Nehsto/Magnetic-Actuation-Board/Board_V2.0/CAD_files/MagnetCore_h=1cm.SLDPRT

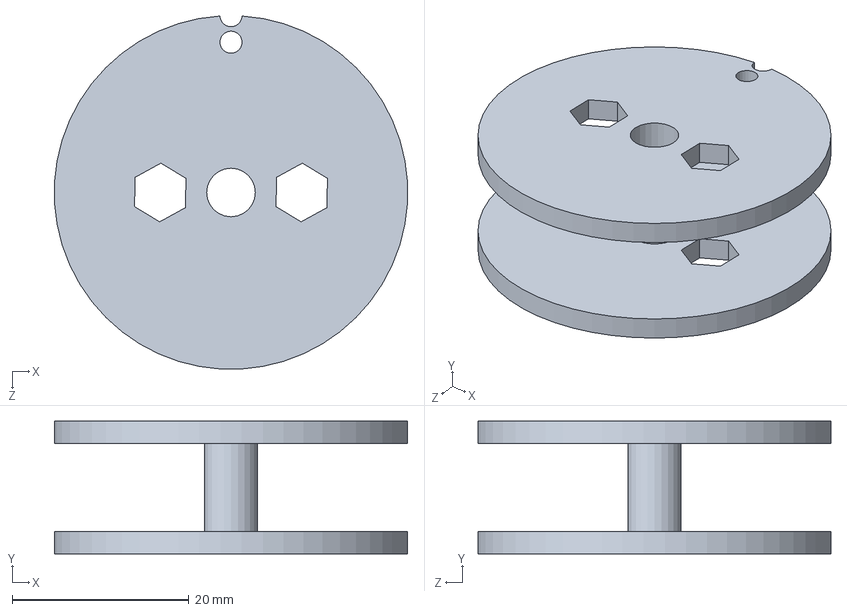
[picture p9: CAD file, 2025-11-26]
Board_V2.0/CAD_files/MagnetCore_h=1cm.SLDPRT
39.9 x 15.0 x 39.9 mm
