Nehsto/Magnetic-Actuation-Board/Board_V2.0/CAD_files/BoardHold.SLDPRT

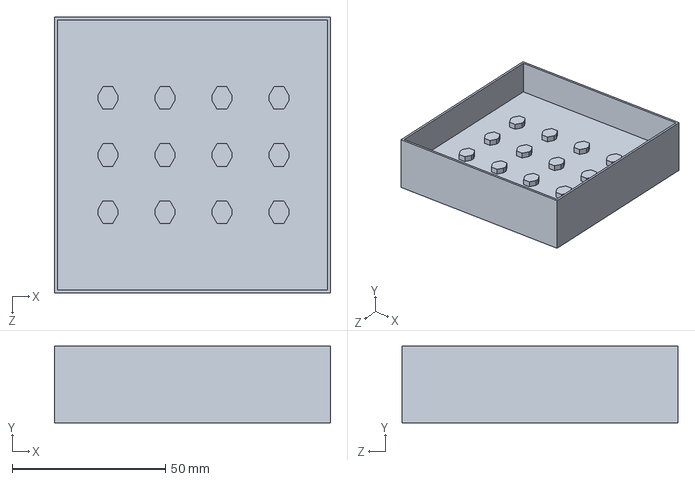
[picture p10: CAD file, 2025-11-26]
Board_V2.0/CAD_files/BoardHold.SLDPRT
90.0 x 25.0 x 90.0 mm
