Nehsto/Magnetic-Actuation-Board/Board_V2.0/CAD_files/Electromagnet v3.stl

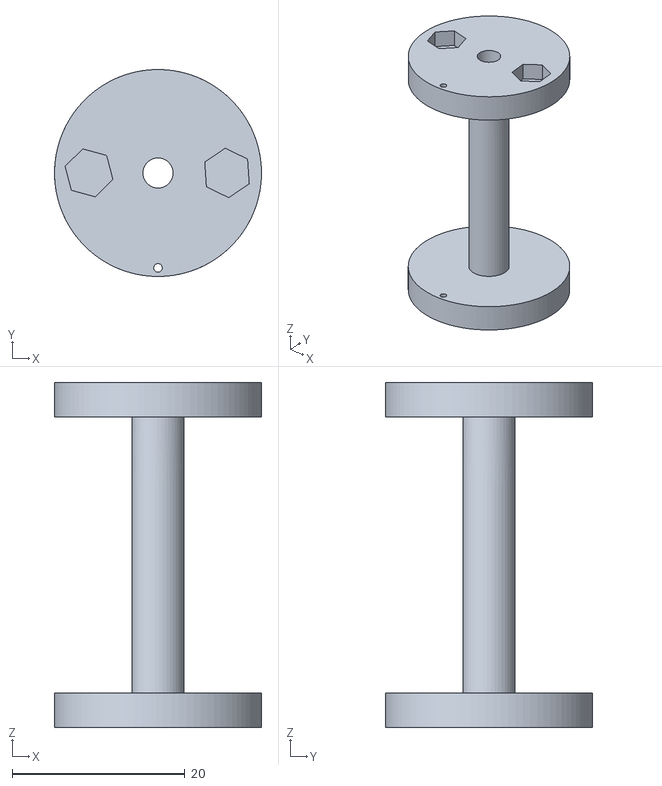
[picture p11: CAD file, 2025-11-26]
Board_V2.0/CAD_files/Electromagnet v3.stl
24.0 x 24.0 x 40.0
