Nehsto/Magnetic-Actuation-Board/Board_V2.0/CAD_files/MagnetCore_h=3cm.SLDPRT

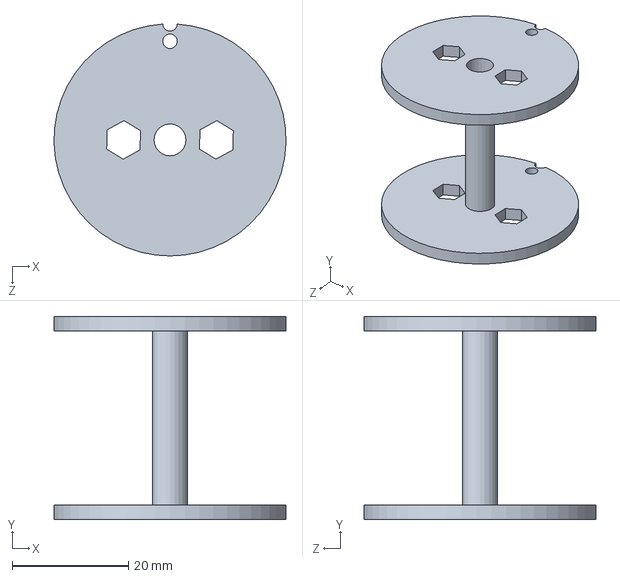
[picture p12: CAD file, 2025-11-26]
Board_V2.0/CAD_files/MagnetCore_h=3cm.SLDPRT
40.0 x 35.0 x 40.0 mm
