Nehsto/Magnetic-Actuation-Board/Board_V2.0/CAD_files/16_mag_base.SLDPRT

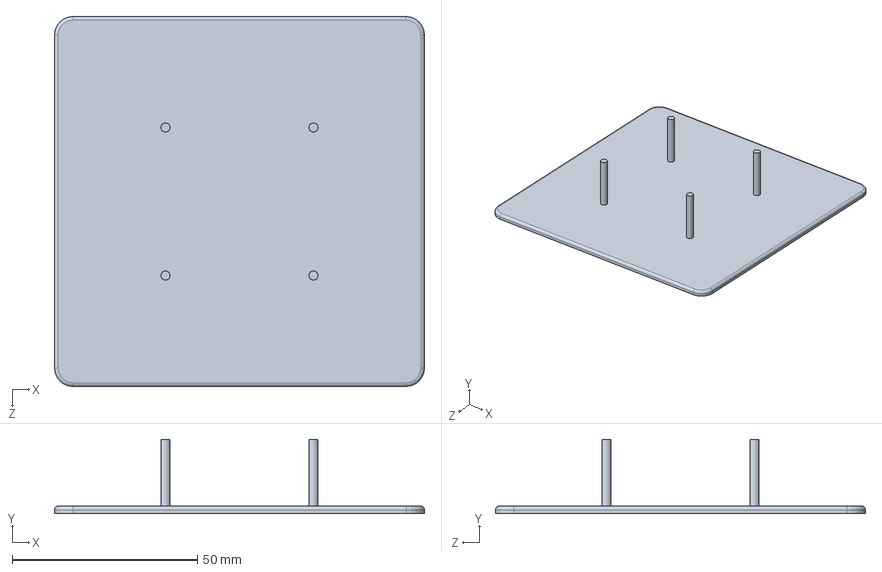
[picture p13: CAD file, 2025-11-26]
Board_V2.0/CAD_files/16_mag_base.SLDPRT
100.0 x 20.0 x 100.0 mm
