Nehsto/Magnetic-Actuation-Board/Board_V2.0/CAD_files/MagnetCore_small.SLDPRT

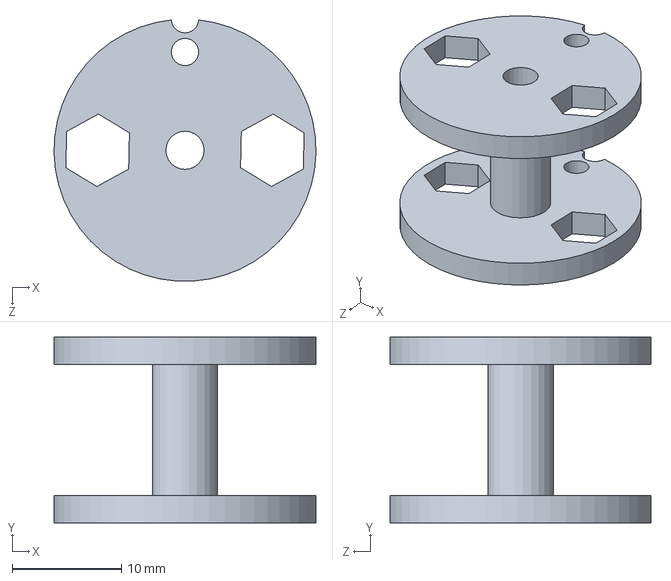
[picture p14: CAD file, 2025-11-26]
Board_V2.0/CAD_files/MagnetCore_small.SLDPRT
24.0 x 17.0 x 23.9 mm
