Nehsto/Magnetic-Actuation-Board/Board_V2.0/CAD_files/MagnetTest.SLDPRT

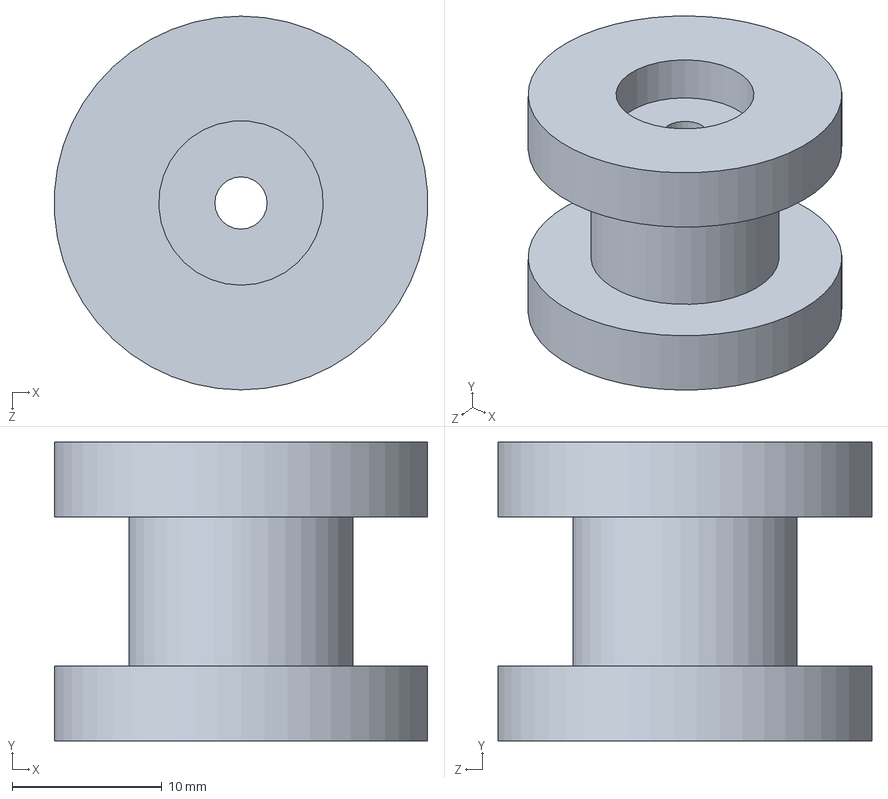
[picture p15: CAD file, 2025-11-26]
Board_V2.0/CAD_files/MagnetTest.SLDPRT
25.0 x 20.0 x 25.0 mm
