Nehsto/Magnetic-Actuation-Board/Board_V2.0/CAD_files/MagnetCore_FINALDESIGN.SLDPRT

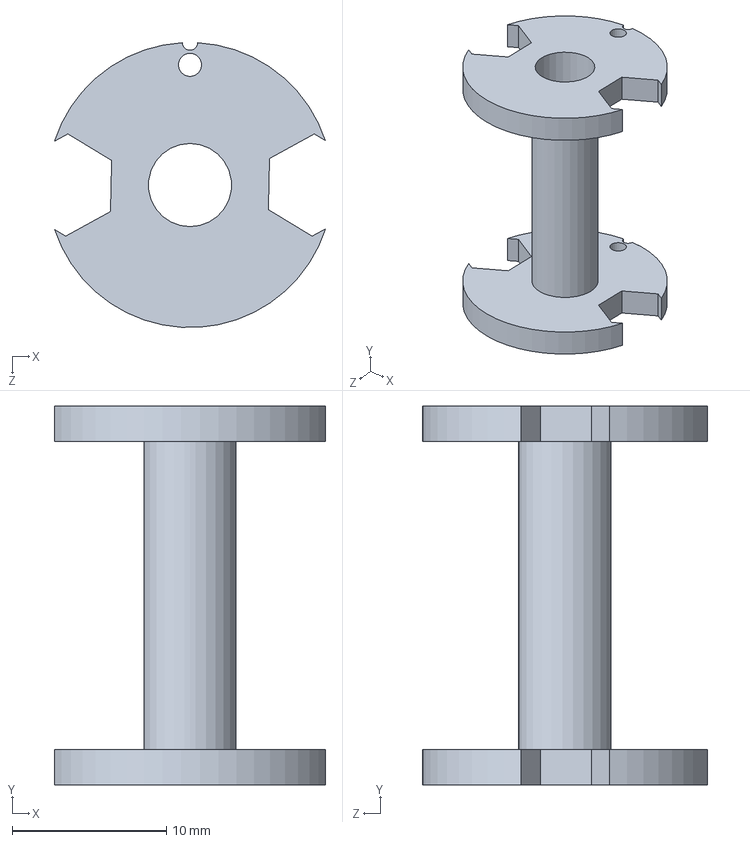
[picture p16: CAD file, 2025-11-26]
Board_V2.0/CAD_files/MagnetCore_FINALDESIGN.SLDPRT
17.6 x 24.6 x 18.5 mm
