Nehsto/Magnetic-Actuation-Board/Board_V2.0/CAD_files/MagnetCore_h=1.5cm.STL

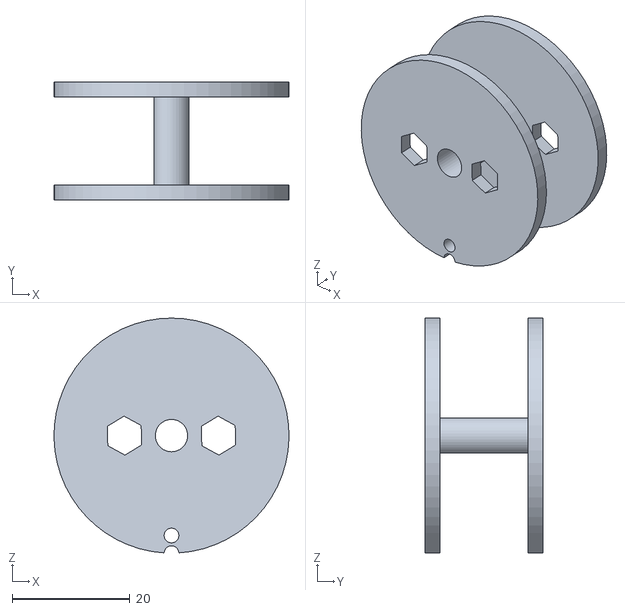
[picture p17: CAD file, 2025-11-26]
Board_V2.0/CAD_files/MagnetCore_h=1.5cm.STL
40.0 x 20.0 x 40.0
