Nehsto/Magnetic-Actuation-Board/Board_V2.0/CAD_files/MagnetCore.SLDPRT

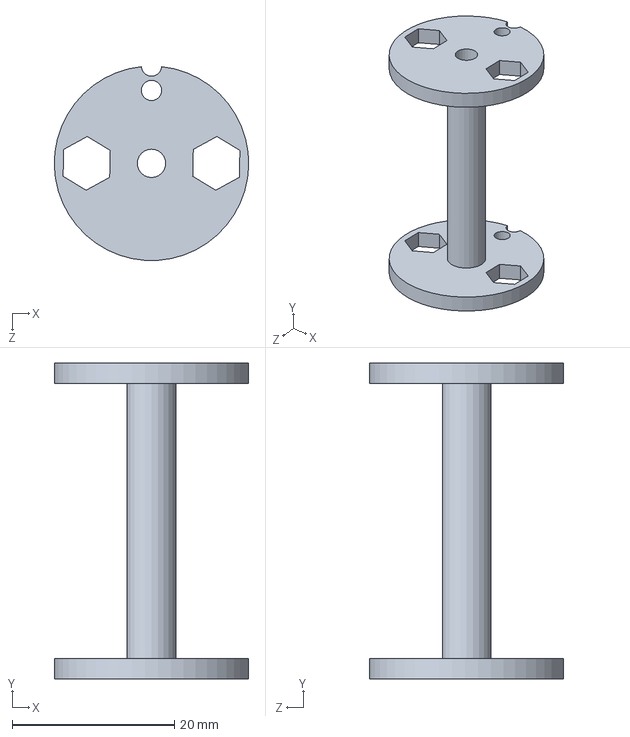
[picture p18: CAD file, 2025-11-26]
Board_V2.0/CAD_files/MagnetCore.SLDPRT
24.0 x 39.0 x 23.9 mm
