Nehsto/Magnetic-Actuation-Board/Board_V2.0/CAD_files/MagnetCore_h=2cm.SLDPRT

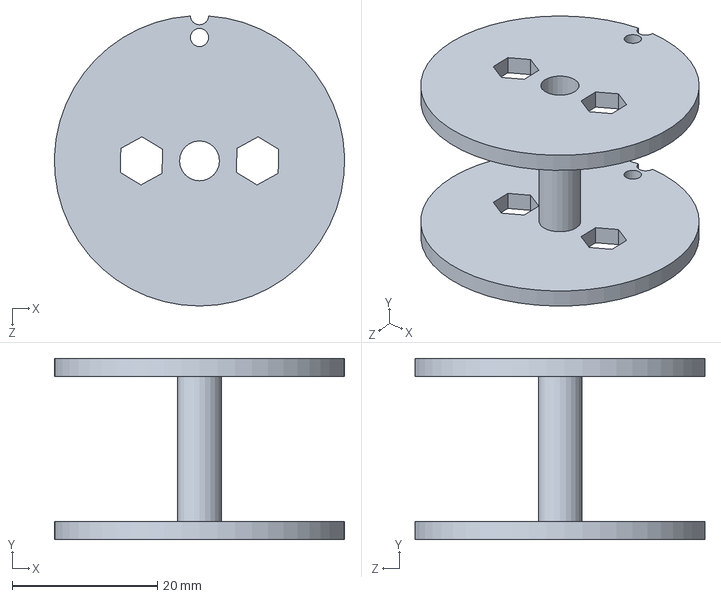
[picture p19: CAD file, 2025-11-26]
Board_V2.0/CAD_files/MagnetCore_h=2cm.SLDPRT
40.0 x 25.0 x 40.0 mm
