Nehsto/Magnetic-Actuation-Board/Board_V2.0/CAD_files/MagnetCore_h=2.5cm.STL

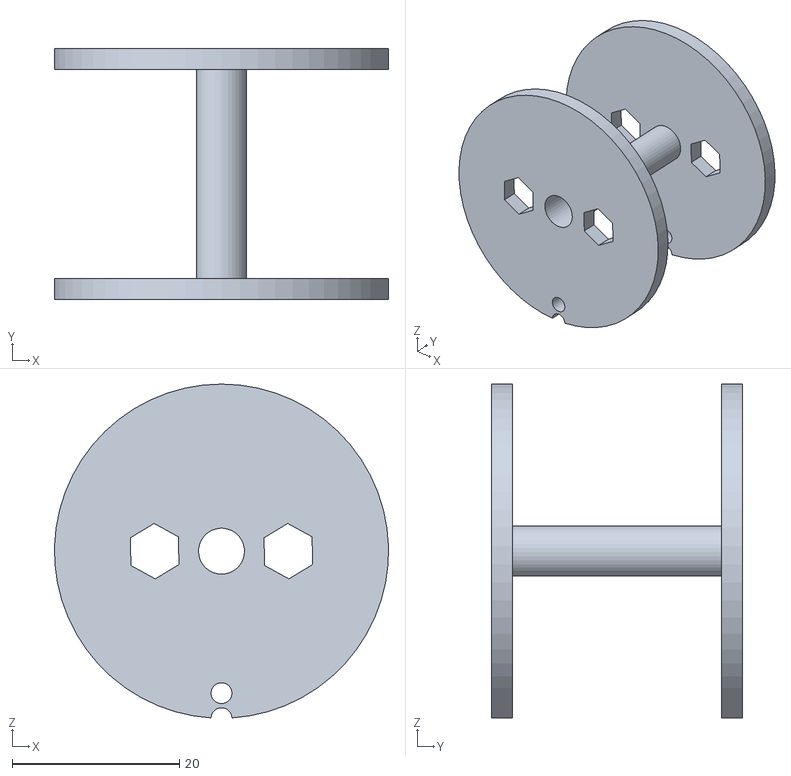
[picture p20: CAD file, 2025-11-26]
Board_V2.0/CAD_files/MagnetCore_h=2.5cm.STL
40.0 x 30.0 x 40.0
