Nehsto/Magnetic-Actuation-Board/(list of files, cad)

Other CAD files:
Board_V2.0/CAD_files/MagnetCore.STL
Board_V2.0/CAD_files/MagnetCore_FINALDESIGN.STL
Board_V2.0/CAD_files/MagnetCore_h=1cm.STL
Board_V2.0/CAD_files/MagnetCore_h=2cm.STL
Board_V2.0/CAD_files/MagnetCore_h=3cm.STL
Board_V2.0/CAD_files/MagnetCore_small.STL
Board_V2.0/CAD_files/MagnetTest.STL
