Nehsto/Magnetic-Actuation-Board/pyScript/test.txt

time_step = 1
row_number = 4
col_number = 4
0 | magnet(3, 2): 0
1 | magnet(3, 2): 100
