Nehsto/Magnetic-Actuation-Board/pyScript/testFiles/test0.txt

# Example file, 4x4 board
# Change options
% interpolate false
# Sequentially set magnets in diagonal to 100% intensity producing a positive B field 
@ 0.5 magnet(1,1) 100
@ 1 magnet(1,2) 100
@ 1.5 magnet(1,3) 100
@ 2 magnet(1,4) 100
@ 2.5 magnet(2,1) 100
@ 3 magnet(2,2) 100
@ 3.5 magnet(2,3) 100
@ 4 magnet(2,4) 100
@ 4.5 magnet(3,1) 100
@ 5 magnet(3,2) 100
@ 5.5 magnet(3,3) 100
@ 6 magnet(3,4) 100
@ 6.5 magnet(4,1) 100
@ 7 magnet(4,2) 100
@ 7.5 magnet(4,3) 100
@ 8 magnet(4,4) 100
@ 8.5 section(1:4,1:4) 0
