Nehsto/Magnetic-Actuation-Board/pyScript/testFiles/test_maze.txt

time_step = 3.0
row_number = 4
col_number = 4
1 | magnet(4, 1): 100
3 | magnet(4, 1): 0, magnet(3, 1): 100
4 | magnet(3, 1): 0, magnet(2, 1) : 100
5 | magnet(2, 1): 0, magnet(2, 2) : 100
6 | magnet(2, 1): 0, magnet(2, 2) : 100
7 | magnet(2, 2): 0, magnet(1, 2) : 100
8 | magnet(1, 2): 0, magnet(1, 3) : 100
9 | magnet(1, 3): 0, magnet(2, 3) : 100
10 | magnet(2, 3): 0, magnet(2, 4) : 100
11 | magnet(2, 4): 0, magnet(3, 4) : 100
12 | magnet(3, 4): 0, magnet(4, 4) : 100
13 | magnet(4, 4): 0, magnet(4, 3) : 100
14 | magnet(4, 3): 0, magnet(4, 2) : 100
15 | magnet(4, 2): 0, magnet(3, 2) : 100
16 | magnet(3, 2): 0, magnet(3, 3) : 100
18 | magnet(3, 2): 0, magnet(3, 3) : 100
