Nehsto/Magnetic-Actuation-Board/pyScript/testFiles/test_period.txt

time_step = 0.5
row_number = 4
col_number = 4
1 | magnet(1, 1): 100, magnet(1, 2): 100, magnet(1, 3): 100, magnet(1, 4) : 100, magnet(2, 1): 100, magnet(2, 2): 100, magnet(2, 3): 100, magnet(2, 4) : 100, magnet(3, 1): 100, magnet(3, 2): 100, magnet(3, 3): 100, magnet(3, 4) : 100, magnet(4, 1): 100, magnet(4, 2): 100, magnet(4, 3): 100, magnet(4, 4) : 100
3 | magnet(1, 1): 0, magnet(1, 2): 0, magnet(1, 3): 0, magnet(1, 4) : 0, magnet(4, 1): 0, magnet(4, 2): 0, magnet(4, 3): 0, magnet(4, 4) : 0
5 | magnet(1, 1): 100, magnet(1, 2): 100, magnet(1, 3): 100, magnet(1, 4) : 100, magnet(4, 1): 100, magnet(4, 2): 100, magnet(4, 3): 100, magnet(4, 4) : 100, magnet(2, 1): 0, magnet(2, 2): 0, magnet(2, 3): 0, magnet(2, 4) : 0, magnet(3, 1): 0, magnet(3, 2): 0, magnet(3, 3): 0, magnet(3, 4) : 0
7 | magnet(1, 1): 0, magnet(1, 2): 0, magnet(1, 3): 0, magnet(1, 4) : 0, magnet(4, 1): 0, magnet(4, 2): 0, magnet(4, 3): 0, magnet(4, 4) : 0
9 | magnet(1, 1): 100, magnet(1, 2): 100, magnet(1, 3): 100, magnet(1, 4) : 100, magnet(4, 1): 100, magnet(4, 2): 100, magnet(4, 3): 100, magnet(4, 4) : 100, magnet(2, 1): 100, magnet(2, 2): 100, magnet(2, 3): 100, magnet(2, 4) : 100, magnet(3, 1): 100, magnet(3, 2): 100, magnet(3, 3): 100, magnet(3, 4) : 100
11 | magnet(1, 1): 0, magnet(1, 2): 0, magnet(1, 3): 0, magnet(1, 4) : 0, magnet(4, 1): 0, magnet(4, 2): 0, magnet(4, 3): 0, magnet(4, 4) : 0
13 | magnet(1, 1): 100, magnet(1, 2): 100, magnet(1, 3): 100, magnet(1, 4) : 100, magnet(4, 1): 100, magnet(4, 2): 100, magnet(4, 3): 100, magnet(4, 4) : 100, magnet(2, 1): 0, magnet(2, 2): 0, magnet(2, 3): 0, magnet(2, 4) : 0, magnet(3, 1): 0, magnet(3, 2): 0, magnet(3, 3): 0, magnet(3, 4) : 0
15 | magnet(1, 1): 0, magnet(1, 2): 0, magnet(1, 3): 0, magnet(1, 4) : 0, magnet(4, 1): 0, magnet(4, 2): 0, magnet(4, 3): 0, magnet(4, 4) : 0
17 | magnet(1, 1): 100, magnet(1, 2): 100, magnet(1, 3): 100, magnet(1, 4) : 100, magnet(4, 1): 100, magnet(4, 2): 100, magnet(4, 3): 100, magnet(4, 4) : 100, magnet(2, 1): 100, magnet(2, 2): 100, magnet(2, 3): 100, magnet(2, 4) : 100, magnet(3, 1): 100, magnet(3, 2): 100, magnet(3, 3): 100, magnet(3, 4) : 100
19 | magnet(1, 1): 0, magnet(1, 2): 0, magnet(1, 3): 0, magnet(1, 4) : 0, magnet(4, 1): 0, magnet(4, 2): 0, magnet(4, 3): 0, magnet(4, 4) : 0
21 | magnet(1, 1): 100, magnet(1, 2): 100, magnet(1, 3): 100, magnet(1, 4) : 100, magnet(4, 1): 100, magnet(4, 2): 100, magnet(4, 3): 100, magnet(4, 4) : 100, magnet(2, 1): 0, magnet(2, 2): 0, magnet(2, 3): 0, magnet(2, 4) : 0, magnet(3, 1): 0, magnet(3, 2): 0, magnet(3, 3): 0, magnet(3, 4) : 0
23 | magnet(1, 1): 0, magnet(1, 2): 0, magnet(1, 3): 0, magnet(1, 4) : 0, magnet(4, 1): 0, magnet(4, 2): 0, magnet(4, 3): 0, magnet(4, 4) : 0
25 | magnet(1, 1): 100, magnet(1, 2): 100, magnet(1, 3): 100, magnet(1, 4) : 100, magnet(4, 1): 100, magnet(4, 2): 100, magnet(4, 3): 100, magnet(4, 4) : 100, magnet(2, 1): 100, magnet(2, 2): 100, magnet(2, 3): 100, magnet(2, 4) : 100, magnet(3, 1): 100, magnet(3, 2): 100, magnet(3, 3): 100, magnet(3, 4) : 100
