Nehsto/Magnetic-Actuation-Board/pyScript/testFiles/test_U_M.txt

time_step = 1
row_number = 4
col_number = 4
1 | magnet(1, 1): 100, magnet(2, 1): 100, magnet(3, 1): 100, magnet(4, 2): 100, magnet(4, 3): 100,  magnet(1, 4): 100, magnet(2, 4): 100, magnet(3, 4): 100
2 | magnet(1, 1): 100, magnet(2, 1): 100, magnet(3, 1): 100, magnet(4, 2): 100, magnet(4, 3): 100,  magnet(1, 4): 100, magnet(2, 4): 100, magnet(3, 4): 100
3 | magnet(1, 1): 100, magnet(2, 1): 100, magnet(3, 1): 100, magnet(4, 2): 100, magnet(4, 3): 100,  magnet(1, 4): 100, magnet(2, 4): 100, magnet(3, 4): 100
4 | magnet(1, 1): 0, magnet(2, 1): 0, magnet(3, 1): 0, magnet(4, 2): 0, magnet(4, 3): 0,  magnet(1, 4): 0, magnet(2, 4): 0, magnet(3, 4): 0
5 | magnet(1, 1): 100, magnet(2, 1): 100, magnet(3, 1): 100, magnet(4, 1): 100, magnet(2, 2): 100, magnet(2, 3): 100, magnet(1, 4): 100, magnet(2, 4): 100, magnet(3, 4): 100, magnet(4, 4): 100
6 | magnet(1, 1): 100, magnet(2, 1): 100, magnet(3, 1): 100, magnet(4, 1): 100, magnet(2, 2): 100, magnet(2, 3): 100, magnet(1, 4): 100, magnet(2, 4): 100, magnet(3, 4): 100, magnet(4, 4): 100
7 | magnet(1, 1): 100, magnet(2, 1): 100, magnet(3, 1): 100, magnet(4, 1): 100, magnet(2, 2): 100, magnet(2, 3): 100, magnet(1, 4): 100, magnet(2, 4): 100, magnet(3, 4): 100, magnet(4, 4): 100
8 | magnet(1, 1): 0, magnet(2, 1): 0, magnet(3, 1): 0, magnet(4, 1): 0, magnet(2, 2): 0, magnet(2, 3): 0,  magnet(1, 4): 0, magnet(2, 4): 0, magnet(3, 4): 0, magnet(4, 4): 0
