Nehsto/Magnetic-Actuation-Board/pyScript/testFiles/test_U_path.txt

time_step = 3
row_number = 4
col_number = 4
1 | magnet(1, 1): 100,
4 | magnet(1, 1): 100,
5 | magnet(1, 1) : 0, magnet(2, 1): 100
6 | magnet(2, 1) : 0, magnet(3, 1): 100
7 | magnet(3, 1) : 0, magnet(4, 2): 100
8 | magnet(4, 2): 0, magnet(4, 3): 100
9 | magnet(4, 3): 0, magnet(3, 4): 100
10 | magnet(3, 4): 0, magnet(2, 4): 100
11 | magnet(2, 4): 0, magnet(1, 4): 100,
14 | magnet(2, 4): 0, magnet(1, 4): 100,
