Nehsto/Magnetic-Actuation-Board/pyScript/testFiles/test_zigzag_two.txt

time_step = 3.0
row_number = 4
col_number = 4
1 | magnet(1, 1): 100, magnet(4, 4) : 100
5 | magnet(1, 1): 100, magnet(4, 4) : 100
6 | magnet(1, 1): 0, magnVet(1, 2) : 100, magnet(4, 4):0, magnet(4, 3):100
7 | magnet(1, 2): 0, magnet(1, 3) : 100, magnet(4, 3):0, magnet(4, 2):100
8 | magnet(1, 3): 0, magnet(1, 4) : 100, magnet(4, 2):0, magnet(4, 1):100
9 | magnet(1, 4): 0, magnet(2, 4) : 100, magnet(4, 1):0, magnet(3, 1):100
10 | magnet(2, 4): 0, magnet(2, 3) : 100, magnet(3, 1):0, magnet(3, 2):100
11 | magnet(2, 3): 0, magnet(2, 2) : 100, magnet(3, 2):0, magnet(2, 2):100
13 | magnet(2, 3): 0, magnet(2, 2) : 100, magnet(3, 2):0, magnet(2, 2):100
