Nehsto/Magnetic-Actuation-Board/Board_V2.0/pcb/MagneticActuationBoard/MagneticActuationBoard.kicad_pcb

## KiCad design Board_V2.0/pcb/MagneticActuationBoard/MagneticActuationBoard.kicad_pcb (2025-11-26)

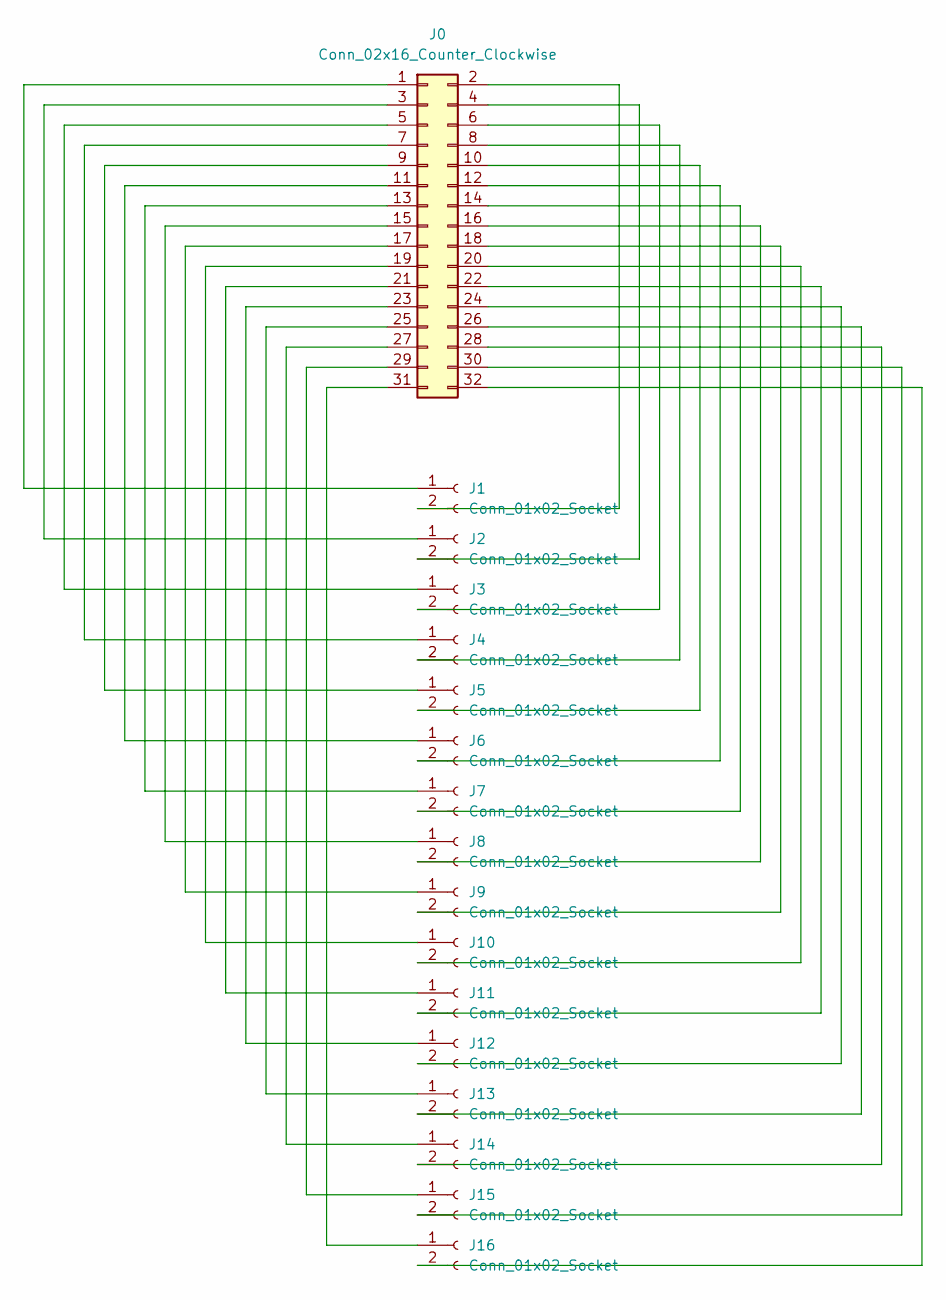
[picture p21: schematic magnet_holder.kicad_sch]

Parts:
J0: Conn_02x16_Counter_Clockwise; PinHeader_2x16_P2.54mm_Vertical
J1, J2, J3, J4, J5, J6, J7, J8, J9, J10, J11, J12, J13, J14, J15, J16: Conn_01x02_Socket; PinHeader_1x02_P2.54mm_Vertical

Connections:
unnamed: J0.1, J1.1
unnamed: J0.2, J1.2
unnamed: J0.3, J2.1
unnamed: J0.4, J2.2
unnamed: J0.5, J3.1
unnamed: J0.6, J3.2
unnamed: J0.7, J4.1
unnamed: J0.8, J4.2
unnamed: J0.9, J5.1
unnamed: J0.10, J5.2
unnamed: J0.11, J6.1
unnamed: J0.12, J6.2
unnamed: J0.13, J7.1
unnamed: J0.14, J7.2
unnamed: J0.15, J8.1
unnamed: J0.16, J8.2
unnamed: J0.17, J9.1
unnamed: J0.18, J9.2
unnamed: J0.19, J10.1
unnamed: J0.20, J10.2
unnamed: J0.21, J11.1
unnamed: J0.22, J11.2
unnamed: J0.23, J12.1
unnamed: J0.24, J12.2
unnamed: J0.25, J13.1
unnamed: J0.26, J13.2
unnamed: J0.27, J14.1
unnamed: J0.28, J14.2
unnamed: J0.29, J15.1
unnamed: J0.30, J15.2
unnamed: J0.31, J16.1
unnamed: J0.32, J16.2

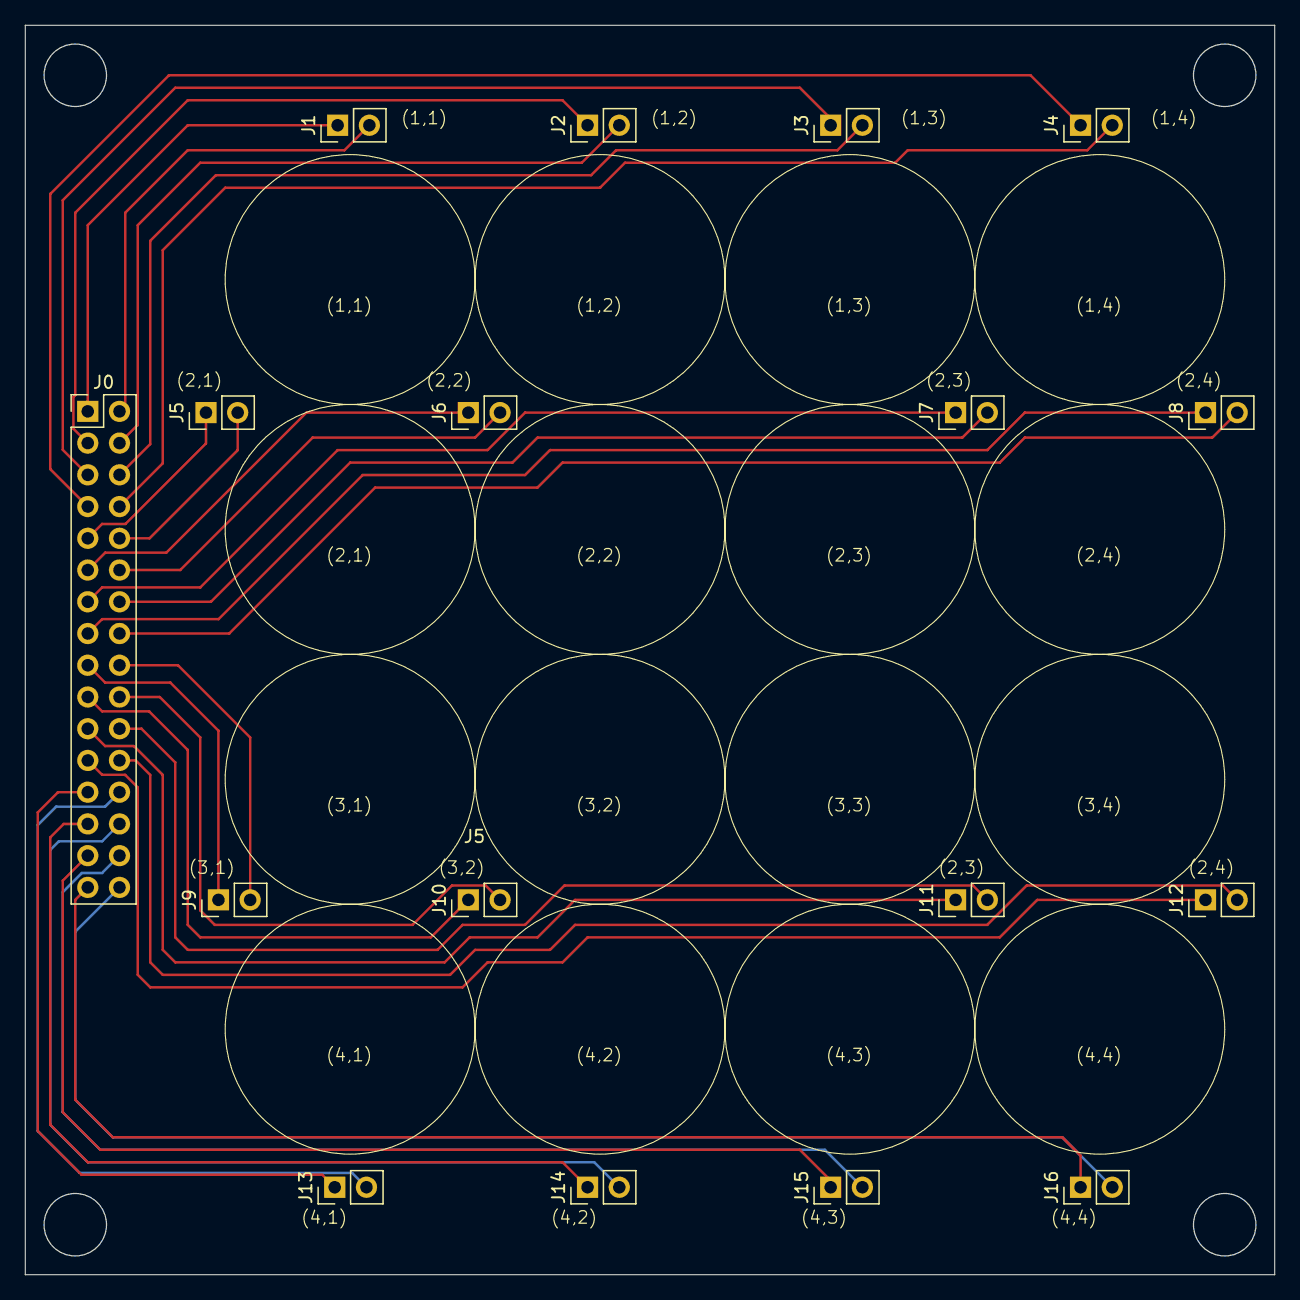
[picture p22: board MagneticActuationBoard.kicad_pcb from above]

Board: 2 copper layers, 100.0 x 100.0 mm, 17 parts (0 on the bottom side), 32 nets.
